saganash-21/Schmitt-Trigger-Interface/media/Breadboard_top.jpeg

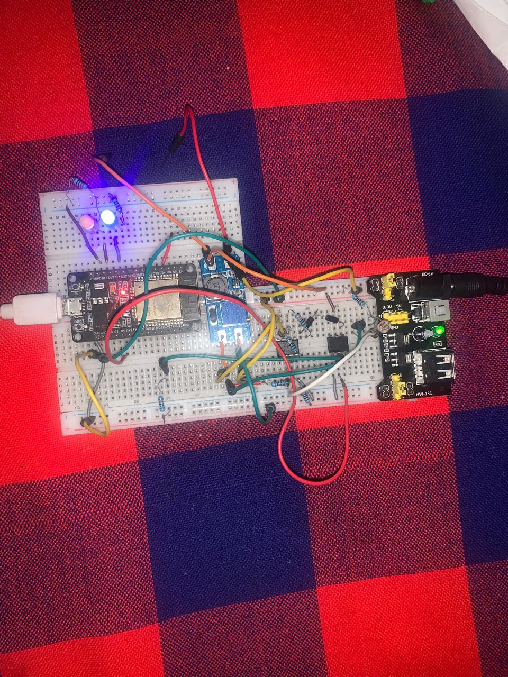
media/Breadboard_top.jpeg
