saganash-21/Schmitt-Trigger-Interface/media/connection.jpeg

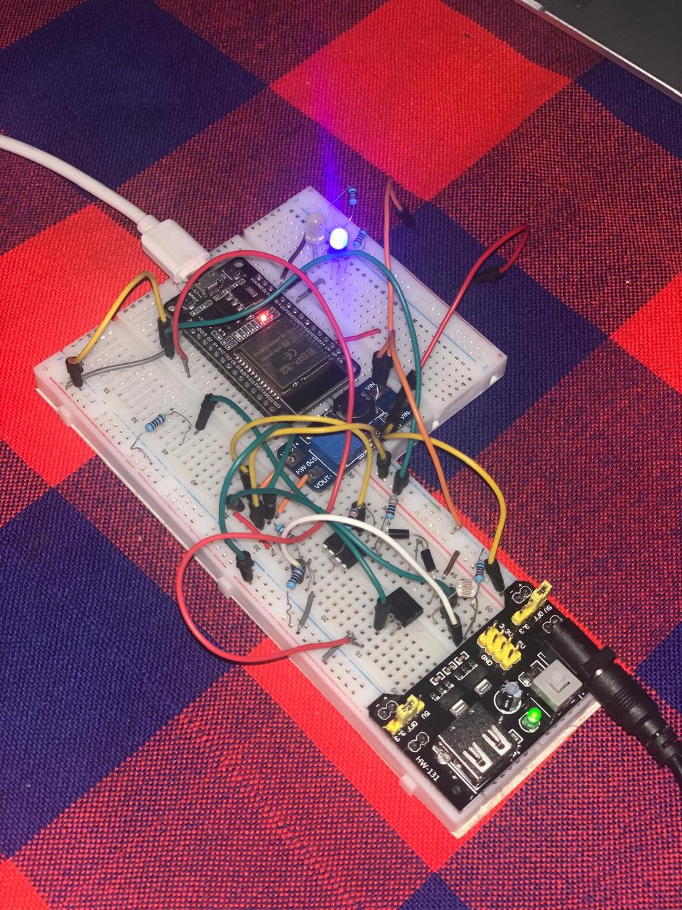
media/connection.jpeg
