saganash-21/Schmitt-Trigger-Interface/hardware/schematic/schematic.pdf

100k | 1N⁴⁰⁰⁴ ¹N⁴⁰⁰⁴ 4N35 | GND

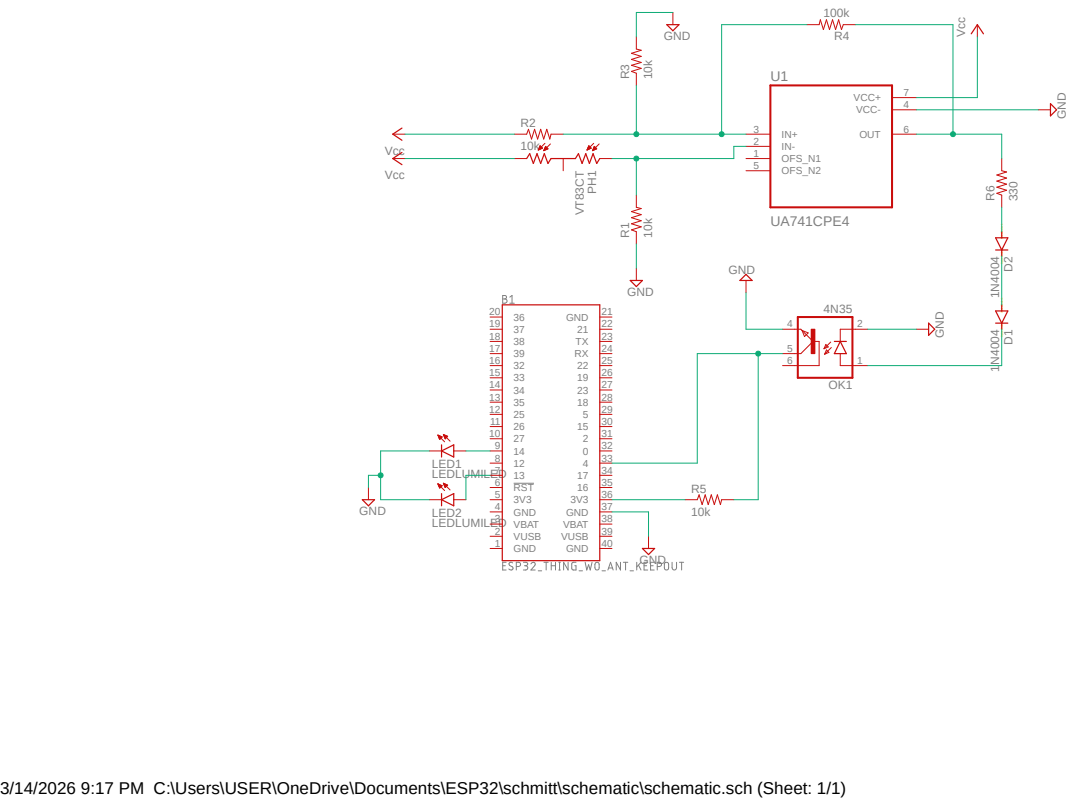
[picture p4: page 1]
3/14/2026 9:17 PM C:\Users\USER\OneDrive\Documents\ESP32\schmitt\schematic\schematic.sch (Sheet: 1/1); SpiceOrder 1 SpiceOrder 2 SpiceOrder 1 SpiceOrder 2; UA741CPE4; Vcc; GND; GND VT83CT; LEDLUMILED; IN+ 3 IN- 2 OFS_N1 1 OFS_N2 5; VCC+; VCC-; OUT; R³ PH¹; GND 1; VUSB 2; VBAT 3; GND 4; RST 6; 40 VUSB; 39 VBAT; 38 GND; 22 GND; LED1; LED2
