saganash-21/Schmitt-Trigger-Interface/hardware/schematic/schematic.sch

## EAGLE design hardware/schematic/schematic.sch (2026-03-14)

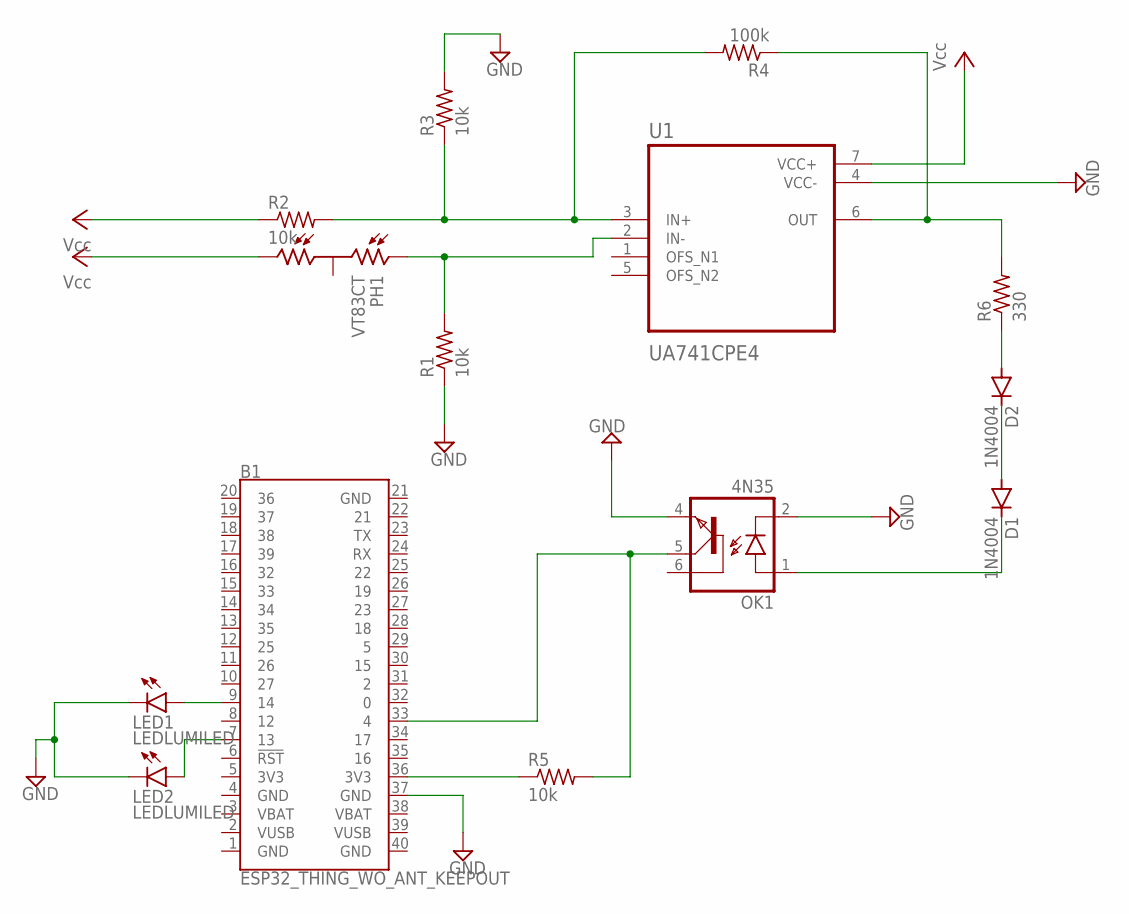
[picture p5: schematic schematic.sch]

Parts:
B1: ESP32_THING_WO_ANT_KEEPOUT; ESP32_THING_NO_ANT
D1, D2: 1N4004; DO41-10
LED1, LED2: LEDLUMILED; LUMILED
OK1: 4N35; DIL06
PH1: VT83CT; VT800CT
R1, R2, R3, R5: 10k; 0204/7
R4: 100k; 0204/7
R6: 330; 0204/7
U1: UA741CPE4; DIP794W45P254L959H508Q8

Connections:
GND: B1.37 (GND), LED1.4- (C), LED2.4- (C), OK1.2 (C), OK1.4 (EMI), R1.1, R3.2, U1.4 (VCC-)
unnamed: R2.2, R3.1, R4.2, U1.3 (IN+)
unnamed: PH1.1, R1.2, U1.2 (IN-)
unnamed: D2.A, R6.1
unnamed: R4.1, R6.2, U1.6 (OUT)
unnamed: B1.33 (4), OK1.5 (COL), R5.2
unnamed: D1.A, D2.C
unnamed: D1.C, OK1.1 (A)
unnamed: B1.36 (3V3), R5.1
unnamed: B1.9 (14), LED1.2+ (A)
unnamed: B1.7 (13), LED2.2+ (A)
VCC: PH1.3, R2.1, U1.7 (VCC+)
