saganash-21/Schmitt-Trigger-Interface/(notices)

Notices in the files:
README.md:
License: MIT
parts and their libraries:
SparkFun-Boards: Licensing: Creative Commons ShareAlike 4.0 International - https://creativecommons.org/licenses/by-sa/4.0
